bespokegear/4BikePedalPowerChallenge/doc/diagrams/20161006-pedal_control_unit_4_input.png

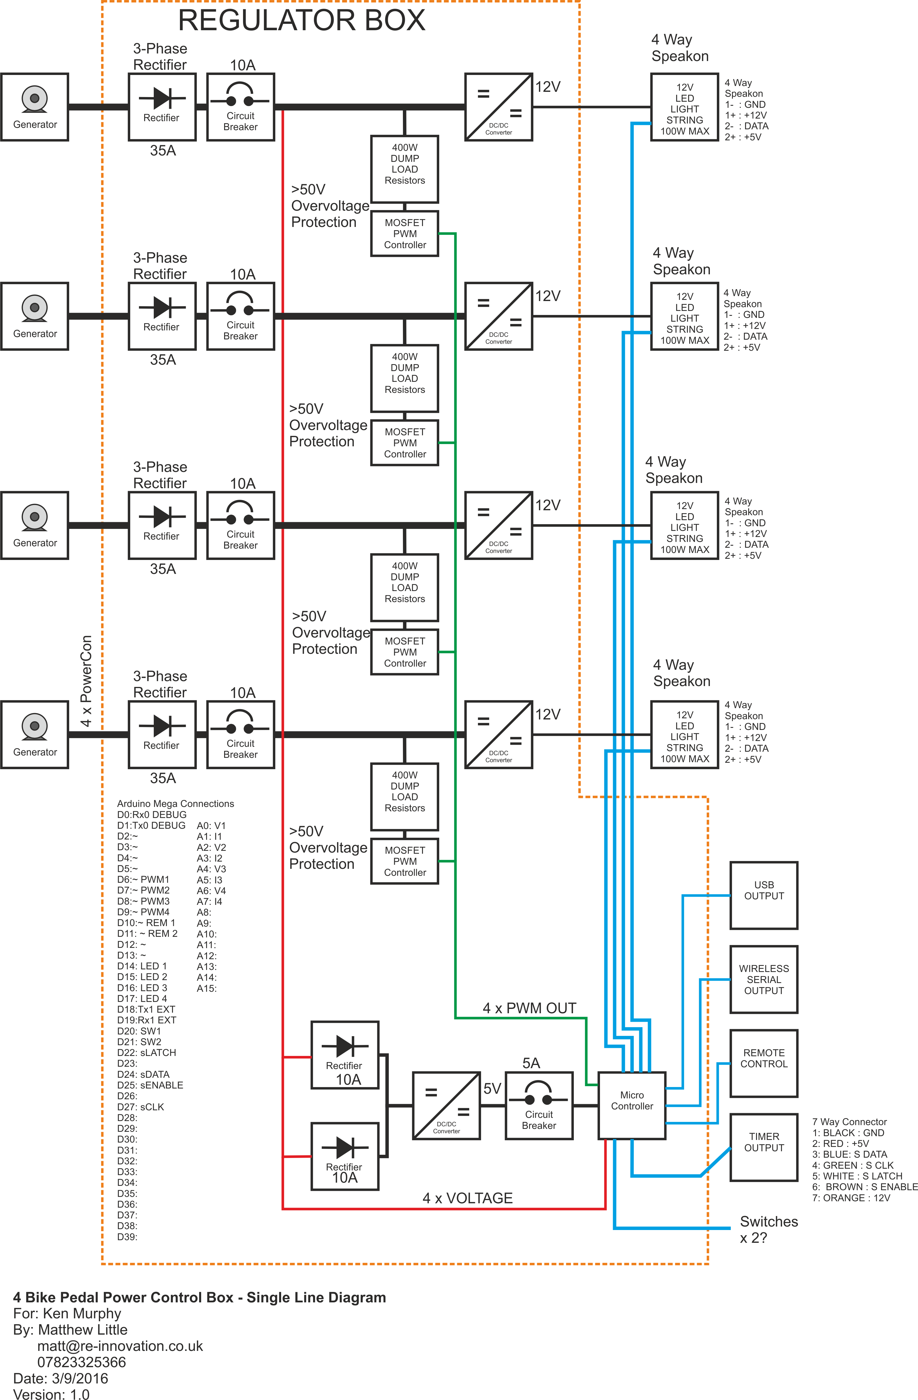
doc/diagrams/20161006-pedal_control_unit_4_input.png
