bespokegear/4BikePedalPowerChallenge/firmware/firmware.ino

////////////////////////////////////////////////////////////////
//                                                            //
// 4-Bike Pedal Powered Challenge Firmware for Arduino Nano   //
// ========================================================== //
//                                                            //
// Copyright (C) 2016 Renewable Energy Innovation Ltd.        //
//                                                            //
// Author:              Mouse (Orthogonal Systems Ltd.)       //
// Project Start Date:  2016-11-03                            //
//                                                            //
////////////////////////////////////////////////////////////////

// Even though these libraries are only used in other sources, we
// #include them here so the Ardino IDE knows to compile and link 
// them...
#include <EEPROM.h>
#include <Adafruit_NeoPixel.h>

// General Arduino features
#include <Arduino.h>

// For watchdog
#include <avr/wdt.h>

// General configuration
#include "Config.h"

// One #include per system object we will use
#include "PwmConfig.h"
#include "Heartbeat.h"
#include "ButtonA.h"
#include "ButtonB.h"
#include "WaitMode.h"
#include "PromoMode.h"
#include "CountdownMode.h"
#include "GameMode.h"
#include "EndGameMode.h"
#include "SettingsMode.h"
#include "ArduinoVin.h"
#include "ClockDisplay.h"
#include "Players.h"
#include "Util.h"
#include "Settings.h"

// Use or own implementation of millis()
#include "CorrectedMillis.h"

// Global variables - we begin in Wait Mode
Mode* mode = &WaitMode;

#ifdef DEBUGTIME
unsigned long lastLoop = 0;
#endif

void setup()
{
    Serial.begin(115200);
    Serial1.begin(115200);

    // Use external reference
    analogReference(VIN_REF);

    // Set up PWM clocks
    PwmConfig();

    // Set up the blinker
    Heartbeat.begin();

    // Init buttons (set pin modes)
    ButtonA.begin();
    ButtonB.begin();

    // Init pins for clock display
    ClockDisplay.begin();
    ClockDisplay.clear();

    // Init player objects
    for (uint8_t i=0; i<PLAYER_COUNT; i++) {
        Players[i].begin();
    }

    // Init game modes
    WaitMode.begin();
    PromoMode.begin();
    CountdownMode.begin();
    GameMode.begin();
    EndGameMode.begin();
    SettingsMode.begin();

    // Let things settle
    delay(500);

    // Call start for current mode
    mode->start();

    // Enable watchdog reset at 1/4 sec
    wdt_enable(WDTO_250MS);

}

void loopDebug()
{
#ifdef DEBUGMODE
    if (mode == &WaitMode) {
        Serial.println(F("in WaitMode"));
    }
    else if (mode == &PromoMode) {
        Serial.println(F("in PromoMode"));
    }
    else if (mode == &CountdownMode) {
        Serial.println(F("in CountdownMode"));
    }
    else if (mode == &GameMode) {
        Serial.println(F("in GameMode"));
    }
    else {
        Serial.println(F("Unknown mode!"));
    }
#endif 

#ifdef DEBUGTIME
    Serial.print(F("looptime="));
    Serial.println(millis() - lastLoop);
    lastLoop = millis();
#endif

#ifdef DEBUGMEM
    Serial.print(F("free="));
    Serial.println(freeMemory());
#endif
}

void switchMode(Mode* newMode)
{
    mode->stop();
    mode = newMode;
    mode->start();
}

void loop()
{
    // Feed the watchdog
    wdt_reset();

    // Dump debugging to serial (if #defined)
    loopDebug();

    // Give a time slice to all system components
    Heartbeat.update();
    ButtonA.update();
    ButtonB.update();
    for (uint8_t i=0; i<PLAYER_COUNT; i++) {
        Players[i].update();
    }

    // Detect button presses and behave appropriately
    if (ButtonA.isPressed()) {
        if (mode == &WaitMode || mode == &PromoMode) {
            switchMode(&CountdownMode);
        } else if (mode == &CountdownMode) {
            switchMode(&GameMode);
        } else if (mode == &GameMode) {
            switchMode(&EndGameMode);
        } else if (mode == &EndGameMode) {
            switchMode(&WaitMode);
        }
    }

    if (ButtonB.isPressed()) {
        if (mode == &WaitMode || mode == &PromoMode) {
            switchMode(&SettingsMode);
        } else if (mode != &SettingsMode) {
            switchMode(&WaitMode);
        } 
    }

    // Give a timeslice to the current mode
    mode->update();

    // Handle modes timing out
    if (mode->isFinished()) {
        if (mode == &WaitMode) { switchMode(&PromoMode); }
        else if (mode == &PromoMode) { switchMode(&WaitMode); }
        else if (mode == &CountdownMode) { switchMode(&GameMode); }
        else if (mode == &GameMode) { switchMode(&EndGameMode); }
        else if (mode == &SettingsMode) { switchMode(&WaitMode); }
    }
}
