bespokegear/4BikePedalPowerChallenge/ProcessingCode/PedalGeneratorViewer_MK1/PedalPowerDisplayApp/PedalConstants.pde

static class PedalConstants{
  
  public static final int numDisplays = 4;
  public static final boolean pedalDisplay = true;
  public static final boolean settingsDisplay = false; 
  
  public static final int     BUTTON_WIDTH  = 100;
  public static final int     BUTTON_HEIGHT = 30;
  public static final int     MARGIN = 10;
  
  public static final int     backgroundCol = 50;
  
  public static final int     baudRate = 115200;
  
  public static int[] allCols = new int[] {#FF0000, #00FF00, #0000FF, #FFFF00};
  public static int[] dimCols = new int[] {#ba2828, #3ab23e, #534f7f, #c6c23b};
}
