bespokegear/4BikePedalPowerChallenge/firmware/LoadedPlayer.h

#pragma once

#include "Config.h"
#include "Player.h"

class LoadedPlayer : public Player {
public:
    LoadedPlayer(uint8_t vinPin, uint16_t r1KOhm, uint16_t r2KOhm, 
                 uint8_t curPin, float vSupply,
                 uint8_t ledPin, uint16_t ledCount, neoPixelType ledType,
                 uint32_t ledColor, uint32_t maxColor, uint8_t pwmPin);
    void begin();
    void update();
    uint8_t getPwm() { return (uint8_t)_pwmLoad; }

private:
    uint8_t _pwmPin;
    uint8_t _pwmLoad;
    unsigned long _last;
};
