bespokegear/4BikePedalPowerChallenge/firmware/Players.cpp

#include "LoadedPlayer.h"
#include "Config.h"

LoadedPlayer Players[PLAYER_COUNT] = {
    LoadedPlayer(PLAYER_VIN_PINS[0], PLAYER_VIN_R1, PLAYER_VIN_R2,
                 PLAYER_IIN_PINS[0], PLAYER_VSUP[0],
                 PLAYER_LED_PINS[0], PLAYER_SEGMENT_LEDS*PLAYER_SEGMENT_MAX, PLAYER_LED_TYPE,
                 PLAYER_LED_COLOR[0], PLAYER_MAX_COLOR[0], PLAYER_PWM_PINS[0]),
    LoadedPlayer(PLAYER_VIN_PINS[1], PLAYER_VIN_R1, PLAYER_VIN_R2,
                 PLAYER_IIN_PINS[1], PLAYER_VSUP[1],
                 PLAYER_LED_PINS[1], PLAYER_SEGMENT_LEDS*PLAYER_SEGMENT_MAX, PLAYER_LED_TYPE,
                 PLAYER_LED_COLOR[1], PLAYER_MAX_COLOR[1], PLAYER_PWM_PINS[1]),
    LoadedPlayer(PLAYER_VIN_PINS[2], PLAYER_VIN_R1, PLAYER_VIN_R2,
                 PLAYER_IIN_PINS[2], PLAYER_VSUP[2],
                 PLAYER_LED_PINS[2], PLAYER_SEGMENT_LEDS*PLAYER_SEGMENT_MAX, PLAYER_LED_TYPE,
                 PLAYER_LED_COLOR[2], PLAYER_MAX_COLOR[2], PLAYER_PWM_PINS[2]),
    LoadedPlayer(PLAYER_VIN_PINS[3], PLAYER_VIN_R1, PLAYER_VIN_R2,
                 PLAYER_IIN_PINS[3], PLAYER_VSUP[3],
                 PLAYER_LED_PINS[3], PLAYER_SEGMENT_LEDS*PLAYER_SEGMENT_MAX, PLAYER_LED_TYPE,
                 PLAYER_LED_COLOR[3], PLAYER_MAX_COLOR[3], PLAYER_PWM_PINS[3])
};
