bespokegear/4BikePedalPowerChallenge/firmware/RawButton.cpp

#include <Arduino.h>
#include "RawButton.h"

RawButton::RawButton(uint8_t pin, bool pullup) : 
    _pin(pin),
    _pullup(pullup)
{
}

void RawButton::begin()
{
    if (_pullup) {
        pinMode(_pin, INPUT_PULLUP);
    } else {
        pinMode(_pin, INPUT);
    }
}

bool RawButton::isPressed()
{
    if (_pullup) {
        return !digitalRead(_pin);
    } else {
        return digitalRead(_pin);
    }
}
