bespokegear/4BikePedalPowerChallenge/(commit log)

2016-11-07 a Player isa VoltageSampler
2016-11-07 add stand-alone CurrentSampler
2016-11-07 A Player ISA CurrentSampler
2016-11-07 Fix subtle behaviour problem with LatchedButton
    LatchedButton was failing ti register an isPressed event properly
    because the underlyting DebouncedButton was getting reset when
    LatchedButton::update checked isPressed internally, not leaving
    the press available for public code.
    Also tweaked timings for better responsiveness.
    [DebouncedButton.cpp, DebouncedButton.h]
2016-11-07 All phyiscal buttons can now be LatchedButtons
    ...because of the recent bugfix to LatchedButton::isPressed. This
    means we can mix and match isPressed and wasPressed happily.
2016-11-07 test buttons and Players
2016-11-07 move button config into Config.h
2016-11-08 Added constant mode to DebouncedButton
    This means we now have the option of the old behaviour (the default),
    where the button triggers momentarily when pressed, and then repeats
    a press signal once every BUTTON_NOREPEAT_MS. We now have the
    additional option of setting isPressed(constant=true), which means
    isPressed will return true for as long as the button is pressed.
2016-11-08 Pin change to match new wiring
2016-11-08 Re-org Config; move FUDGE; param-ize analogRef
    Setting analogReference type and reference voltage are now
    controlled from the Config.h file; and voltage / current calcs
    use these values un Util.*. Config re-org a bit.
    Moved the FUDGE voltage adjustment (which is for voltage drop
    over diodes on input from pedal generators); into the Player
    class.
2016-11-08 calibrate current calculation
2016-11-08 fix letters for new 7 seg display type
    [SevenSegmentDisplay.cpp]
2016-11-08 final (?) fix for 7seg digits
    [SevenSegmentDisplay.cpp]
2016-11-08 increase v and i samples for smoothing
2016-11-10 Configure Pwm registers for faster Pwm frequency
2016-11-10 apply faster PWM
2016-11-10 reset max; fix display
    [GameMode.cpp]
2016-11-10 fix suble game end calc bug
    [GameMode.cpp]
2016-11-10 add missing include (debug mem only)
    [firmware.ino]
2016-11-10 remote control buttons
2016-11-10 make countdown interruptable
2016-11-10 rename buttons
2016-11-10 more button sanity
2016-11-11 use millis() with offset value
2016-11-11 apply clock correction on LED.show
    [Config.h, Player.cpp, Player.h]
2016-11-11 debug print player maxPower values
2016-11-11 better button feel
2016-11-11 multitude of little fixes
    [Config.h, CountdownMode.cpp, GameMode.cpp, GameMode.h, LoadedPlayer.cpp, WaitMode.cpp, firmware.ino]
2016-11-12 new button implementation
2016-11-14 use function to calculate LED count (clarity)
2016-11-21 Added Processing Code
    Code from Tom G. Working. Needsd couple of changes
2016-12-09 Fix DEBUG mode
    Serial.print statements in constructors causing problems during init,
    removed
    [PromoMode.cpp, SettingsMode.cpp, WaitMode.cpp]
2016-12-09 Change of LED type
2016-12-09 Fix integer overflow
    If the maximum power was very high (probably not possible with a pedal
    generator, but revealed in testing with a pot on the vIn pin), the
    integer used to generated the aRESULT value would overflow and the
    result would be garbled. Fixed here by changing to a int32_t.
    [GameMode.cpp]
2016-12-13 Fix end game max line bug
    The max line for non-winning players was plotting on line
    too high. Fix this with minimal code change (as we ship soon).
    [EndGameMode.cpp]
2016-12-13 tweak button responsiveness
